jSchmidt-design/irtactile-belt/hardware/wiring.html

irtactile-belt · docs/hardware/wiring.md · branch v1

# Belt Wiring Plates

An ESP32 devkit driving two AASD-15A servo drives through a dual DAC, a three-relay enable bank and four differential line receivers. Every ESP32-side value here is read out of the firmware; drive-side terminal numbers come from the manufacturer diagram.

CONTROLLERESP32 devkit, CH340 DRIVES2 × AASD-15A DACGP8413, I²C 0x58 TICK6 kHz playout OPEN ITEMS30 TBD

Signal classes — click to trace Enable & safety Analog command Encoder feedback Serial, panel & power

Plate 01

## Control topology

wiring.md §intro

Five subsystems. The host only ever writes; the ESP32 only ever logs back on a separate wire. Everything the ESP32 commands leaves through the interface column in the middle — a relay bank for the enables, a DAC for the torque command — and the only thing that comes back from the drives is the encoder pair, through four line receivers.

Read the arrows, not the boxes. The host link is one-way (host → device) and the log link is one-way the other way, so a stalled bridge is invisible to the ESP32 except as an underrun. The only closed loop in the drawing is safety switch → relay 3 → GPIO 19: the hardware kill and the firmware’s knowledge of it come from the same contact. Green hops show where the encoder return crosses the analog command — no connection.

Two paths, one switch

Cutting the safety switch starves the relay boards’ input optocouplers. All three relays open: drives #1 and #2 are disabled in hardware, and GPIO 19 goes HIGH, which makes the firmware declare INACTIVE and command 0 V. Neither path needs the other to work, and the hardware one is faster — the relay opens immediately, the firmware notices on its next 100 ms poll. Plate 04 draws the mechanism.

Plate 02

## ESP32 pin map

wiring.md §1

Thirteen pins, and that is the whole of it. Every GPIO the firmware touches is below; anything not drawn here is unused. Tab colour is the signal class.

Boot order matters here. Pins 12 and 13 come up HIGH, so both relays are open and the drives are inactive for the first ~1 s of every boot. They go LOW immediately before dac.begin() — a few hundred microseconds live against an unconfigured DAC.

Every GPIO the firmware touches
GPIO | Dir | Function | Configured as | Source
1 | out | UART0 TX — data link, unused | 1 200 000 8N1 | .ino:27
3 | in | UART0 RX — tactile sample stream | 1 200 000 8N1 | .ino:26
4 | in | Encoder ch1 A (pulse) | PCNT 0, rising edge | Counter.h:7
5 | in | Encoder ch1 B (direction) | PCNT 0 control | Counter.h:8
13 | out | Servo enable 2 — relay, active low | HIGH at boot, LOW after 1 s | .ino:56, 397
14 | out | Diagnostic / scope trigger | driven LOW, never toggled | .ino:41
16 | in | UART1 RX — logging, unused | 115 200 8N1 | .ino:18
17 | out | UART1 TX — log output | 115 200 8N1 | .ino:19
18 | in | Mode button, momentary to GND | INPUT_PULLUP, 50 ms | .ino:84
19 | in | Status input | INPUT_PULLUP; HIGH ⇒ INACTIVE | .ino:46
21 | I/O | I²C SDA to GP8413 | pull-up on, 1 MHz | GP8413_DAC.h:10
22 | out | I²C SCL to GP8413 | pull-up on, 1 MHz | GP8413_DAC.h:11
25 | out | Servo enable 1 — relay, active low | HIGH at boot, LOW after 1 s | .ino:55, 396
26 | in | Encoder ch2 A (pulse) | PCNT 1, rising edge | Counter.h:11
27 | in | Encoder ch2 B (direction) | PCNT 1 control | Counter.h:12

GPIO 12 is deliberately unused, and must stay that way

It is the MTDI strapping pin: it must read LOW at reset or the chip selects a 1.8 V VDD_SDIO and the flash supply is wrong. Drive 1’s enable used to live here, and a relay board’s IN pin is not high-impedance — it is the cathode of the input optocoupler LED, fed from the board’s VCC through roughly 1 kΩ, so it pulls toward 3.3 V. Against GPIO 12’s weak internal pull-down (~45 kΩ) that divider sits near 2 V, a solid logic HIGH — and the firmware’s own boot state for the pin was HIGH as well. The symptom is a board that boots with the safety switch open and unreliably or not at all with it closed, since the switch controls the very VCC that creates the pull-up. Drive 1’s enable is now GPIO 25 — no strapping or boot-log role, and four header positions from 12 on the same side of the devkit, so the relay wire still reaches. Leave GPIO 12 unconnected, and do not fit a stronger external pull-down instead: that fights the opto LED current and makes the relay’s turn-on marginal.

Plate 03

## Torque command path

wiring.md §2–3

The ESP32 has no analog output, so the torque command for both drives is generated by one GP8413 dual 15-bit DAC on I²C. Both channels are written in a single auto-incrementing 5-byte transaction, once per 6 kHz tick — about 56 µs of the 167 µs budget.

The module (DFRobot Gravity, DFR1073) has only four terminals on its input side — D, C, +, −. It runs from a single 5 V rail (its datasheet supply) shared with the rest of the control side; an on-board boost converter makes the 0–10 V output, so there is no separate high-voltage analog supply.

Return topology is a star, not a daisy chain. Each drive gets its own AGND conductor back to the DAC ground point, so neither drive’s return current flows through the other’s reference. The hops on the ground wire are crossings, not junctions — the only junction is the marked star point.

DAC configuration written at startup — GP8413_DAC.h
Item | Value | Meaning
I²C address | 0x58 | GP8413_ADDRESS
Bus speed | 1 MHz | above the GP8413’s specified 400 kHz
Range register 0x01 | 0x77 | OUTPUT_RANGE_10V → 0–10 V both channels
CH0 data register | 0x02 / 0x03 | low byte, high byte (7 bits)
CH1 data register | 0x04 / 0x05 | same auto-incrementing transaction
Update rate | 6 kHz | one 5-byte write per tick, ~56 µs of 167 µs
Full scale | 32767 = 10.000 V | code 0 = 0 V, 1 LSB ≈ 0.305 mV

Only half the drive’s input range is reachable

The Vref input accepts −10 V … +10 V, but the GP8413 produces 0 … +10 V only. The drives never see a negative command, so the belt pulls in one direction per channel. That matches the firmware — processData() takes max(stream, encoder) and clamps at zero, never a signed value — and the mechanics: channel 2 gets its opposing direction from being mounted opposite-handed, not from the command sign.

TBD on this plate

External I²C pull-up value actually fitted (internal ~45 kΩ is marginal at 1 MHz) · shielded pair for the analog run, shield grounded at one end · drive parameters: control mode, full-scale voltage, gain, offset, dead band, torque limit, speed limit — and that 0 V is exactly zero torque, not a bipolar mid-scale.

AGND is not isolated

Unlike the enable path, the analog command shares a ground: both drives’ pin 13 and the GP8413 ground meet at the DAC, and through the devkit that net reaches USB ground and the host PC. The star topology removes the drive-to-drive coupling, but not the path to the PC.

Plate 04

## Enable & safety chain

wiring.md §4

The ESP32 does not drive the servo-on inputs directly. Each enable GPIO drives a relay, and the relay contact sits in the drive’s enable path — the module provides both the level shift and the isolation. The safety switch is not in the coil current and not in any mains circuit: it sits in the 3.3 V supply to the relay boards’ input side, so it is an ordinary low-voltage, low-current switch with no special rating.

Relay 3 has no GPIO of its own. Its input is wired straight to ground, so its optocoupler conducts whenever the switched 3.3 V is present and stops the moment it is not. It is a direct electrical report of the safety switch, which the firmware reads on GPIO 19. Hops on the 5 V drops mark crossings over the 3.3 V bus — the two rails never meet.

What the switch does
Safety switch | Relay boards | Relays 1 & 2 | Relay 3 | GPIO 19 | Result
on | 3.3 V present | firmware-controlled | closed | LOW | normal operation
off | inputs starved | open — drives disabled | open | HIGH | INACTIVE, DAC commanded to 0 V

Relay interface
Item | Value
Relay | SRD-05VDC-SL-C on a standard maker relay board, 5 V version
Relay count | three — two for the drives, one for the status input
Input (control) voltage | 3.3 V — driven directly by the ESP32 GPIO
Coil voltage | 5 V, from the USB rail (JD-VCC, unswitched)
Opto supply | 3.3 V through the safety switch (VCC)
Coil driver, flyback diode, input opto | on the module — nothing external needed
GPIO level → contact | HIGH = open = drive inactive · LOW = closed = drive active
Connector on the AASD-15A carrying pin 6 | TBD

The VCC–JD-VCC jumper must stay removed

Separating those two rails is what puts the safety switch in the path at all. Refitting the jumper — the default state these boards ship in — would tie VCC to the unswitched 5 V and silently defeat the kill path: the relays would keep working normally, and the only symptom would be a safety switch that no longer does anything. Check this after any board swap or repair.

Fail-safe in the right direction

The contact is normally open, so a de-energised relay, a broken coil wire, a lost coil supply, an unpowered or resetting ESP32 all leave pin 6 floating and the drives inactive. Activation requires the firmware to actively hold the GPIO low. Re-arming is not automatic — when the switch returns, the firmware moves to PRE_INITIALIZED, which is only left by pressing the mode button.

Plate 05

## Drive-side input circuit

wiring.md §4

The AASD-15A digital inputs are optocoupler inputs sharing one common anode terminal, with a 5 kΩ series resistor internal to the drive. This is the manufacturer’s “switch input method”: supply positive to pin 9, supply negative to COM(10), and a contact between the two energises the LED.

The isolation barrier is the drive’s own optocoupler, so nothing on the ESP32/USB side is galvanically tied to the drive’s internal or power ground. The relay contact adds a second, independent break in the same loop.

Why pin 9 runs at 5 V and not 12–24 V — LED forward current
Pin 9 supply | LED current | Relative
24 V | ≈ 4.6 mA
12 V (datasheet minimum) | ≈ 2.2 mA
5 V — as built | ≈ 0.76 mA

5 V is below the specified range on paper, but driving these inputs from a 5 V logic rail is long-established practice in the SFX-100 motion-simulator community, which has used the same AASD-15A drives this way for years across a large number of builds. The optocoupler turns on reliably at this current; the field record is the justification, and it lets the whole control side run from the single USB 5 V rail with no separate 24 V supply.

If a build ever does show marginal or intermittent enabling, the remedy needs no rework of the control side: the relay contact is dry and already isolating, so pin 9 can be moved to 12 V or 24 V while the coil stays at 5 V and the GPIO at 3.3 V. Only the wire into pin 9 and the contact’s return change.

CN2 digital inputs — what is used
Pin | Signal | Drive function | Used
9 | DC12~24V | input common, anode side | yes — fed 5 V here
6 | SigIn1 | SRV-ON | yes — the enable
7 | SigIn2 | Alarm Reset | no
21 | SigIn3 | Position deviation clear | no
8 | SigIn4 | ZEROSPD | no
10 | COM | input common return (supply negative) | TBD — see above

TBD on this plate

Is COM(10) wired, or does the relay go straight to the USB 0 V? Electrically equivalent only if that 0 V is the supply negative. · How the unused inputs are left — floating is the inactive state here, since the LED needs a return path to conduct. · The 5 V current budget: two relay coils plus the ESP32 all run from the same USB rail, and a small 5 V coil is typically 70–80 mA, so both energising together is a meaningful step load on a rail that is also feeding the devkit regulator.

Two drive outputs would answer questions the system cannot presently answer

SigOut1 (pin 11) is SRV-READY — the drive telling the controller it is ready. SigOut2 (pin 23) is alarm detection: a faulted drive is currently invisible to the firmware and to the log. Both are open-collector, both unwired. TBD: whether GPIO 19’s status input is fed from SigOut1 on one of the drives, or from something else entirely.

Plate 06

## Encoder feedback

wiring.md §5

The source is the drive’s position pulse output on CN2 — a differential line-driver copy of the motor encoder, referenced to DGND. The line-driver pairs do not go to the ESP32 directly: each pair is received by its own small RS-485-to-TTL module, used purely as a differential line receiver. One module per signal, four in total.

The 3.3 V supply is what makes RXD directly GPIO-safe. Running the modules from the ESP32’s own 3V3 rail means their logic outputs cannot exceed the rail the GPIOs are referenced to — no level shifting anywhere in the encoder path. A 5 V-powered module, or a MAX485 board which looks identical, would put 5 V on pins rated 3.6 V absolute maximum.

Four modules, one per signal
Module | Input A+ / B− | Output RXD → | Carries | PCNT behaviour
1 | #1 PA+ (20) / PA− (19) | GPIO 4 | ch1 A phase | unit 0, rising edge = 1 count
2 | #1 PB+ (18) / PB− (17) | GPIO 5 | ch1 B phase | B low ⇒ count down, high ⇒ up
3 | #2 PA+ (20) / PA− (19) | GPIO 26 | ch2 A phase | unit 1, rising edge = 1 count
4 | #2 PB+ (18) / PB− (17) | GPIO 27 | ch2 B phase | mirrored: B low ⇒ count up

The firmware counts rising edges on A only, and uses the level of B at that edge to pick the direction — a 1× decode, not 4×.

CH2’s direction modes are deliberately the mirror of CH1’s because the second unit is mounted opposite-handed (Counter.h:87–88). Do not tidy them to match. Nothing between the drive and the GPIO flips polarity, so if a counter ever reads backwards the cause is mechanical handing or a swapped pair at the terminals.

Counter behaviour
Item | Value | Notes
Glitch filter | 80 APB cycles = 1 µs | rejects switching noise; passes up to ~500 kHz
Counter width | signed 16-bit | wraps to 0 at ±32767/−32768 — it does not saturate
Reset | on button release | this is the zero the preload is measured from
Z / index | PZ± (15/16), OZ (22) | available, unused — one pulse per revolution, no absolute reference

Counts are never converted to distance, and do not need to be

The drives run in torque mode, so the encoder is not used to measure or command position. The count is a relative displacement from the zero set at arming, and it feeds a floor under the torque command that rises as the belt is pulled out — a virtual spring, not a position loop. That makes the counts-to-DAC gain a tuned feel parameter rather than a calibrated mapping: there is no counts-per-revolution figure to record. The one number that matters is where the floor saturates.

TBD on this plate

Confirm the exact transceiver marking (MAX3485-type assumed) · confirm only the module terminates — each pair is point-to-point, so one 120 Ω termination per pair is right; if the drive also has a termination option enabled, or a module is daisy-chained, the load halves. Keep TXD disconnected: the 74HC04 auto-direction circuit enables the RS-485 driver when TXD goes low, which would put it in contention with the drive’s own line driver.

Plate 07

## Operating states

wiring.md §6–7

Two inputs move the system: the status input on GPIO 19, which the safety switch drives through relay 3, and the momentary mode button on GPIO 18. Everything else is a consequence.

A restored safety switch never brings the system straight back to driving. GPIO 19 going low only reaches PRE_INIT; leaving it requires a deliberate press of the mode button.

Voltage presented to each drive, per state
State | Channel voltage
INACTIVE | 0 V — status pin 19 is high
PRE_INITIALIZED | 0 V — waiting for the button
INITIALIZING | fixed code 2000 = 0.610 V on both channels
INITIALIZED | max(stream sample, encoder-derived level) per channel
Underrun > 250 ms | ramps to 0 V over 50 ms, and back up over 50 ms on recovery

Front panel / operator controls
ESP32 | Control | Wiring | Behaviour
GPIO 18 | Mode button | momentary switch to GND, INPUT_PULLUP | held = INITIALIZING; released = INITIALIZED, encoders zeroed
GPIO 19 | Status input | relay 3 contact to GND, INPUT_PULLUP | HIGH (open) = INACTIVE, outputs forced to 0 V. LOW permits arming.
GPIO 14 | Diagnostic | test point / scope probe | driven LOW at startup; no toggling in the firmware

TBD on this plate

Connector, cable and enclosure details for the panel controls. · Which physical drive is “channel 1”. The firmware pairs the encoder inputs with the DAC channels, but nothing ties ENABLE_PIN_1 (GPIO 25) to the drive fed by VOUT0 — that is purely a wiring convention and must be recorded.

Plate 08

## Signal scaling

wiring.md §7

Two paths reach the DAC and the larger of them wins. The stream path is the tactile sample arriving over UART0. The encoder path is a torque floor that rises with displacement: value = 3 × counter × 32767 / 20000, saturated at 32767. Pulling the belt out raises the minimum force while the tactile stream still modulates above it.

The nominal 20 000 count clamp never binds on its own — the output saturation at 32767 is what actually holds the ceiling, at 6 667 counts. Beyond that, pulling further adds no more force. Hover the plot to read a value.

Encoder path — mapTo15bit(), irtactile-belt.ino:171
Encoder counts | DAC code | Volts
1 | ≈ 4.9 | ≈ 1.5 mV
100 | 491 | 0.150 V
1 000 | 4 915 | 1.500 V
3 333 | 16 383 | 5.000 V
6 667 | 32 767 | 10.000 V — full scale
≥ 6 667 | 32 767 | 10.000 V — clamped

Stream path — host-bridge → UART0 → ring → 6 kHz playout → DAC
Stage | Range | Volts at the drive
Wire sample (15-bit) | 0 … 32767 | —
DAC code | 0 … 32767 | 0 … 10.000 V
1 LSB | 1 | 0.305 mV

Channel pairing

From processData(): stream slot 1 and encoder ch1 (GPIO 4/5) both feed DAC CH0; stream slot 2 and encoder ch2 (GPIO 26/27) both feed DAC CH1.

Plate 09

## CN2 connector map

wiring.md §10

Nine of the twenty-five conductors are used. Reproduced from the drive’s “speed, torque control wiring diagram” so the plates above can be checked against one list.

Filled pins are wired; hollow pins are available and unwired. Each SigIn has a 5 kΩ series resistor into its optocoupler; Vref enters through 10 kΩ into an op-amp with a 10 kΩ leg to analog ground.

CN2 — control I/O, complete
Pin | Signal | Function | Used
9 | DC12~24V | digital input common (anode side) | 5 V here
6 | SigIn1 | SRV-ON | enable, via relay
25 | Vref | speed/torque analog command, −10…+10 V | ← DAC
13 | AGND | analog ground | ← DAC GND
20 / 19 | PA+ / PA− | A phase pulse output | → PCNT A
18 / 17 | PB+ / PB− | B phase pulse output | → PCNT B
1 | GND (DGND) | pulse output common | → each RS-485 receiver’s line-side earth
7 | SigIn2 | Alarm Reset | would clear a fault without a power cycle
21 | SigIn3 | Position deviation clear | —
8 | SigIn4 | ZEROSPD | —
10 | COM | common for inputs and outputs | TBD
11 | SigOut1 | SRV-READY — open collector | unwired
23 | SigOut2 | Alarm detection — open collector | unwired — faults are invisible
12 | SigOut3 | Position completed | —
24 | SigOut4 | Zero speed | —
15 / 16 | PZ+ / PZ− | Z phase (index) pulse output | available for homing
22 | OZ | Z open-collector output | —
2 | PV | open-collector power for the pulse command inputs | position mode only
3 / 14 | PP+ / PP− | pulse command input | position mode only
4 / 5 | PD+ / PD− | direction command input | position mode only

CN1 communication (unused) & CN3 motor encoder (factory cable)
Connector | Pins | Signal
CN1 | 2 | +5 V power
CN1 | 4 / 6 | RS-485 A / B — how drive parameters are set from a PC
CN1 | 1 / 3 | RS-232 Tx / Rx
CN1 | 5 | Gnd
CN3 | 8 / 15 / 14 | +5 V / GND / PE
CN3 | 3·11 / 10·2 / 1·9 | A± / B± / Z± — the PA/PB outputs on CN2 are the drive’s buffered copy of these
CN3 | 6·7 / 13·12 / 5·4 | U± / V± / W± hall

Plate 10

## Power & grounding

wiring.md §8

The enable path is opto-isolated at the drive. The analog command and the encoder common are not — they are shared nets, and through the devkit they reach USB ground and the host PC.

One barrier, three crossings, one of them broken. The star return topology removes the drive-to-drive coupling on AGND, but not the path back to the PC.

Supplies as built
Item | Value
ESP32 supply | USB, CH340 devkit
Relay coils (×3) | 5 V from the USB rail — JD-VCC, unswitched
Relay board input side | 3.3 V through the safety switch — VCC
AASD-15A servo-on opto supply | 5 V from the USB rail (drive pin 9), below the datasheet’s 12–24 V, deliberately
RS-485→TTL receiver modules (×4) | 3.3 V from the ESP32 devkit’s 3V3 rail
E-stop / kill chain | safety switch in the 3.3 V supply to the relay board inputs — low voltage, low current, no special rating
GP8413 supply | 5 V from the USB rail, single rail — on-board boost makes the 0–10 V output
Drive mains supply | 220 V into L1/L2/L3 + PE — TBD: single or three phase, and via what filter/breaker
Motor cabling | U/V/W + PE — TBD: cable type and gland/shield termination
Motor encoder cabling | CN3, 15-way — TBD: supplied cable or made up?
Ground topology (star point) | TBD — the enable path is opto-isolated, the analog command is not
Shielding and earth bonding | TBD
Fusing | TBD

Host connections
Link | Cable | Notes
Data | USB → CH340 on the devkit | 1 200 000 baud, host → device only. DTR/RTS must stay deasserted or the CH340 auto-reset circuit reboots the ESP32 mid-stream.
Logging | USB-TTL adapter on GPIO 17, or a second ESP32 running tools/logger/logger.ino | 115 200 baud, device → host only. Required equipment — the drift-lock pass criterion is only observable here.

—

## Open items

30 unverified against the build

Everything on the ESP32 side is read out of the firmware and is authoritative. Everything on the drive side — terminal numbers, connector pinouts, level shifting, supplies — needs confirming against the physical build. Collected here so the list can be worked through in one pass with the harness in hand.

### Boot & strapping Plate 02 · 2

- Power-cycle ten times with the safety switch closed, after moving drive 1’s enable from GPIO 12 to GPIO 25. All ten must boot — this is the regression test for the strapping problem, replacing the old “measure GPIO 12 at reset” item.
- Confirm the GP8413 powers up at 0 V on both channels — the drives are enabled a few hundred µs before the range register is written. If not, move the enable writes after dac.begin().

### DAC & analog run Plate 03 · 5

- External I²C pull-up value actually fitted — internal ~45 kΩ is marginal at 1 MHz.
- Shielded pair for the command run, shield grounded at one end.

### Drive parameters Plate 03 · 7

- Control mode — must be torque, analog command.
- Analog input full-scale voltage — 10 V must be the intended maximum torque.
- Analog input gain (torque per volt) — sets the belt’s force scaling.
- Analog input offset / zero — 0 V must be exactly zero torque, not a bipolar mid-scale.
- Analog input dead band.
- Torque / current limit — the safety ceiling independent of the command.
- Speed limit in torque mode — required; torque mode is otherwise unbounded in speed.

### Enable path Plate 05 · 5

- Which connector on the AASD-15A carries pin 6.
- Is COM(10) wired, or does the relay go straight to USB 0 V?
- How the unused digital inputs are left (floating is inactive here).
- Whether GPIO 19’s status input is fed from SigOut1 (SRV-READY) or something else.
- 5 V current budget — two coils at ~70–80 mA plus the ESP32 on one USB rail.

### Encoder receivers Plate 06 · 2

- Confirm the exact transceiver marking (MAX3485-type assumed).
- Confirm only the module terminates — a second 120 Ω halves the load.

### Panel & identity Plate 07 · 2

- Connector, cable and enclosure details for the panel controls.
- Which physical drive is “channel 1” — nothing ties ENABLE_PIN_1 to the drive fed by VOUT0.

### Power & grounding Plate 10 · 7

- Mains: single or three phase, and via what filter / breaker.
- Motor cable type and gland / shield termination.
- CN3 encoder cable — supplied or made up?
- Ground topology — star point, analog vs. power ground.
- Shielding and earth bonding.
- Where the safety switch is mounted, and fusing.

Drawn from docs/hardware/wiring.md. ESP32-side values are authoritative — they are read out of controller-firmware/src/irtactile-belt/. Drive-side terminal numbers follow the AASD-15A “speed, torque control wiring diagram”. Items marked TBD are unverified against the physical build.
