jSchmidt-design/irtactile-belt/(commit log)

2026-08-29 first draft of the belt controller. Includes - firmware - host application - hardware documentation
2026-08-30 Add configurable force-curve tuning (full-scale count + gamma)
    Firmware:
    - ForceCurve.h: clamped gamma LUT built off the tick path, double-buffered
    - 0x02 tuning header decoded in SerialDecoder, refreshed floor-gain hold
    while belt-tune is connected (no sample stream to feed)
    - NVS persistence, clamped on load, committed only on the entry to INACTIVE
    - logging for tuning state and curve rebuilds
    Host bridge:
    - belt-tune tool (BeltTuneMain) and TuningFrame encoder with 2-count /
    Q3.4 wire packing, operator-side clamping
    Docs/tests:
    - protocol.md: tuning header, clamping, hold semantics, sync-run handling
    - forcecurve_test, TuningFrame_test, extended decoder/playout tests
    - hardware/wiri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
2026-11-02 Fix drive CN2 ground pin and encoder receiver grounding in wiring docs (#2)
    - Correct the drive's pulse-output ground from CN2 pin 16 to pin 1 (`DGND`).
    Pin 16 is `PZ−`, a line-driver output, not ground. Fix the Z-phase pair
    to 15/16 (was 15/14).
    - Ground each RS-485 receiver's line-side earth to the drive's pin 1 `GND`
    instead of the controller ground, so each pair keeps its own reference.
    The logic-side `GND` goes to the ESP32 on the 3.3 V side.
    - Document the two ESP32 `GND` wires (5 V rail and 3.3 V rail) in the
    open-items table, and drop the shared GND row from the signal table.
    - List the position-mode command inputs (pins 2–5, 14) in the CN2 pinout,
    and note that they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
